URL42/epaper-cam/(commit log)

2026-08-15 chore: initialise repository
    macOS metadata and Arduino "Export compiled binary" output.
2026-08-15 docs: add hardware reference and build kickoff
    CLAUDE.md is the authoritative hardware reference: bill of materials, the
    Driver Board vs Breakout Board naming trap, pin map, Arduino IDE settings,
    image pipeline constraints and known risks. Items needing bench confirmation
    are marked VERIFY.
    kickoff-prompt.md defines the eight-phase build order, one flashable phase
    at a time.
2026-08-15 feat(phase1): add panel bring-up sketch
    Two full refreshes, nothing else. No camera, no button, no sleep.
    Test A draws asymmetric corner markers, a 1px border, vertical lines every
    100px and text, proving wiring, orientation and refresh timing.
    Test B pushes a raw 48,000-byte packed 1bpp buffer (left half 0xFF, right
    half 0x00) through drawBitmap to settle the bit-polarity VERIFY in the
    format the Phase 4 ditherer will emit.
    driver.h sets BOARD_SCREEN_COMBO 502 and USE_XIAO_EPAPER_DRIVER_BOARD,
    sourced from Seeed's 7.5" panel Arduino cookbook. This resolves the VERIFY
    in CLAUDE.md: the Driver Board wiki's USE_XIAO_EPAPER_BREAKOUT_BOARD is a
    copy-paste error from the Breakout Board page.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
    [driver.h]
2026-08-15 docs: fold Phase 1 bench results into hardware reference
    Both VERIFY markers resolved on hardware:
    - BOARD_SCREEN_COMBO 502 with USE_XIAO_EPAPER_DRIVER_BOARD is correct.
    begin() returns and update() completes, so BUSY is on D2 as documented.
    - Bit polarity is set-bit-equals-black. The ditherer emits 1 for black and
    passes TFT_BLACK as foreground. Seeed's "Reverse color" note describes
    their converter's output, not drawBitmap's input.
    New findings recorded:
    - Origin is top-left, no rotation needed. Test A placed its asymmetric
    markers as intended; Test B ruled out 180 degree rotation and horizontal
    mirroring.
    - Full refresh is 3433 ms, identical across runs. Replaces the ~5s esti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
2026-08-15 feat(phase2): add debounced shutter button with hold detect
    Serial only, panel untouched. Reports TAP (press and release under 1.5s)
    and HOLD (fired the instant 1.5s elapses while still held).
    Design notes:
    - Polling rather than an ISR. A human-pressed button does not justify
    IRAM_ATTR and volatile state, and Phase 7's EXT0 wake is a separate
    hardware mechanism that this does not foreclose.
    - HOLD fires at the threshold, not on release, so Phase 7 can give feedback
    at the moment the mode changes. The hold_reported flag suppresses the tap
    that would otherwise follow on release, so one press yields one event.
    - 25ms debounce. Bench-validated over nine presses with zero double-fires;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
2026-08-15 feat(phase3): add camera bring-up with luma histogram
    Init OV2640 at SVGA grayscale, discard three warmup frames for AGC to
    settle, capture one frame, report format/dimensions/length and a 16-bucket
    luma histogram. Panel untouched.
    Pin map copied verbatim from the ESP32 core's camera_pins.h under
    CAMERA_MODEL_XIAO_ESP32S3, rather than typed from memory. Inlined because
    that header sits in an examples folder outside the sketch include path.
    The verdict block prints last, after the histogram, so the result stays
    visible in a serial monitor scrolled to the bottom.
    Fields needed after capture are copied into locals before
    esp_camera_fb_return, since the driver may recycle the struct for the n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
2026-08-15 docs: record Phase 3 camera measurements
    - CONFIRMED: FRAMESIZE_SVGA with PIXFORMAT_GRAYSCALE returns exactly
    800x600 at 480,000 bytes, one byte per pixel. No JPEG decode step needed.
    - One frame buffer costs 481,376 bytes of PSRAM including driver overhead,
    leaving 7,904,720 free. Roughly 16 frames of headroom, so Phase 6's
    burst-and-pick-sharpest is not memory constrained.
2026-08-15 feat(phase4): add Floyd-Steinberg ditherer with native test harness
    Pure C11, no Arduino headers, no allocation, no I/O. Serpentine scan to
    avoid the diagonal worm texture a plain raster scan produces. Caller owns
    every buffer, so the function cannot fail and has nothing to free.
    800x600 8-bit luma in, packed 1bpp 800x480 out with the 120-row centre crop.
    MSB-first, 1 = black, matching the convention confirmed on the panel in
    Phase 1. Dithers only the 480 kept rows rather than cropping afterwards.
    Error accumulates in int32_t and is clamped to 0..255 before thresholding.
    Accumulating in uint8_t is the usual way this algorithm goes wrong: 255 + 3
    wraps to 2 and a white pixel turns black, wh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
    [dither.c, dither.h]
2026-08-15 feat(tools): add focus assist and scaler A/B bench tools
    Diagnostics for the image-quality investigation. Neither is a build phase.
    FocusAssist prints variance-of-Laplacian over the centre 400x300 several
    times a second, so a fixed-focus lens can be set by watching a number peak
    instead of eyeballing 3.7s panel refreshes. This found the actual problem:
    the lens was badly out of focus, and the score swung 40x across the barrel's
    travel. Peak on a text target is ~824 with +/-0.7% repeatability.
    The peak reading decays rather than latching, since a plain running maximum
    becomes useless the moment you overshoot. Accumulators are int64_t because
    120,000 squared Laplacian values overflow 32 bits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
2026-08-15 feat(tools): add frame dump and host receiver
    Sends one raw 800x600 grayscale frame over serial so tone mapping can be
    developed against real photographs on the Mac rather than guessed at through
    reflash-shoot-squint cycles on the bench.
    Raw bytes rather than base64: this is native USB CDC, where the nominal baud
    is ignored and throughput is USB-limited, so 480KB moves in about half a
    second. Measured 858-877 KB/s.
    recv_frame.py triggers the capture itself, so there is no button timing to
    coordinate, and writes PGM — viewable directly and trivial for the C harness
    to load. It clears DTR/RTS before opening because pyserial's defaults reset
    the S3's USB-Serial/JTAG, and it names the Serial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
    [recv_frame.py]
2026-08-15 feat: add tone mapping ahead of the dither
    A 1-bit panel renders midtones as 50% dot patterns, so a tonally ordinary
    photograph becomes grey mush no matter how sharp it is. tone.c pushes tones
    apart before quantisation.
    Global maths collapses into a 256-entry LUT, so the per-pixel device cost is
    one array lookup rather than two pow() calls. The S-curve is
    x^a/(x^a+(1-x)^a) rather than the usual scale-around-midpoint, because it
    cannot clip: it fixes 0, 0.5 and 1 for every a and only steepens the middle.
    TONE_DEFAULTS was settled empirically with tune against all three reference
    frames. The result was counter-intuitive: contrast 1.5-2.0 crushed the
    backlit portrait to a silhouette, and what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
    [tone.c, tone.h]
2026-08-15 feat(phase5): first working camera, with tone mapping
    Button, capture, tone, dither, blit. Everything the previous phases proved,
    wired together.
    - Shutter fires on the debounced press edge rather than release. Phase 2
    reported on release so it could distinguish a hold; with hold detection out
    of scope here, waiting would add the length of the press to shutter lag.
    - The frame is validated before dither_fs sees it. That function indexes
    480,000 bytes with no bounds checks by design, so the trust has to be
    earned somewhere, and this is where.
    - The frame buffer is returned before the 3.4s panel refresh, not after.
    Holding the driver's only buffer across it would stall the next capt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
    [dither.c, dither.h, driver.h, tone.c, tone.h]
2026-08-15 chore: keep photographs out of the repository
    The reference captures in frames/ are of a real home and a real face. They
    are only needed locally, for tuning the tone curve with dither/tune, so they
    stay on disk and out of git.
    Also drops the earlier !frames/*.pgm exception and removes the commit that
    added them, rather than only ignoring them going forward. An ignore rule does
    nothing about blobs already in history; they would have been published on the
    first push. Safe to rewrite here because this repo has never had a remote.
2026-08-15 feat: add 4-level greyscale dithering
    dither_fs_gray4 keeps the serpentine Floyd-Steinberg structure and changes
    only the quantiser and the output packing: nearest of four evenly spaced
    levels, emitted as 4bpp with two pixels per byte and the high nibble holding
    the even-x pixel. That is precisely the layout initGrayMode(GRAY_LEVEL4)
    gives its sprite, so callers can dither straight into it via getPointer().
    Four levels is not a marginal change. At two levels every pixel is wrong by
    up to 127 and the error has to be spread over a wide neighbourhood, and that
    spreading is what the eye reads as stipple. At four the worst case is ~42,
    diffusion stays local, and the texture largely disappears.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
    [dither.c, dither.h]
2026-08-15 feat: turn sharpening off by default
    At 1-bit the unsharp mask was the main thing making edges read and 0.9 was
    worth its cost. At 4-level grey it turned out to be invisible: a side-by-side
    of 0.9 and 0.0 on the panel was indistinguishable, while still costing 863ms
    of the 894ms tone stage. The levels now do the work the mask used to.
    Measured on device by toggling live: tone 894ms at sharp 0.9, 30ms at 0.0.
    The blur's vertical pass strides 800 bytes per read through PSRAM, which is
    why it dominated. Turning it off deletes the need for the sliding-window
    rewrite that was queued to fix it.
    The unsharp code stays in tone.c. It is tested, cleanly gated behind
    sharp_amt > 0, and costs nothing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
    [tone.h]
2026-08-15 feat(tools): add greyscale test, image test, and test chart
    Three bench tools from the greyscale investigation.
    GrayTest times a 1-bit refresh against a 4-level one and draws bands to
    confirm the levels are genuinely distinct. It is how we learned greyscale
    costs only 1.48x mono rather than the 5-10x that would have killed it.
    ImageTest pushes a pre-processed image straight into the panel from flash,
    with no camera in the loop. This separated two questions that had been
    tangled together for hours — "how good can this panel look" from "how good
    can this camera get" — and answered the first decisively: a good source
    renders with legible body text and smooth walls. Everything remaining is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
2026-08-15 feat(phase5): 4-level greyscale output and live tone tuning
    initGrayMode(GRAY_LEVEL4) at boot, dither_fs_gray4 writing straight into the
    sprite via getPointer(), and epaper.update(). The 48KB 1-bit buffer is gone
    rather than grown to 192KB, and free PSRAM went up 833KB as a result. The
    fillScreen before each blit is gone too: every pixel is written now, so there
    is nothing of the previous photo left to clear.
    Measured on device: capture 0 | tone 30 | dither 135 | paint 5074 | total
    5239 ms. Greyscale costs 1.6s a shot over 1-bit and is worth it without
    argument.
    Serial keys retune tone live — s/S sharpen, g/G gamma, c/C contrast, r/R
    radius, 0 sharpening off, x shoot, ? show values. Tone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
2026-08-15 docs: correct the greyscale premise and record datasheet figures
    The reference claimed the panel was 1-bit only and that dithering was the
    only way to render tone. Both were wrong, and it is the most expensive error
    in this document so far — it framed the entire image pipeline around a
    constraint that did not exist. Corrected in place, with the correction marked
    so the mistake stays visible.
    Recorded from the T075A04 datasheet: UC8179 controller, 124 DPI, white L*=63
    and black L*=32 for a contrast ratio near 4.5:1, ghosting dE <= 2, 100 mAs
    per update, 11 mA update current, 7 uA panel sleep. Those numbers also settle
    a Phase 7 question early: at 0.028 mAh a refresh, a 1000mAh cell covers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
2026-08-16 fix: dither against measured grey levels, not assumed ones
    dither_fs_gray4 assumed the four levels rendered at 0/85/170/255. Measured
    with PaperCam_GrayCalib they are nearer 0/60/138/255 — the waveform spaces
    them evenly in perceived lightness, which is not even in luminance.
    This was not cosmetic. Error diffusion subtracts the value it believes it
    wrote and passes the remainder on, so believing 85 while the panel shows 60
    injected 25 of unaccounted error per pixel. It accumulated as a systematic
    darkening over three quarters of every image, and no tone curve could undo it
    because the tone curve runs first. It explains why on-panel results always
    came out heavier than the previews promise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
    [dither.c, dither.h]
2026-08-16 feat(tools): add grey level calibration sketch
    Measures the two middle grey levels by comparison rather than instrumentation.
    Each solid level sits beside eight black/white Bayer patches at known white
    fractions; the one it disappears into gives that level's true reflectance as a
    fraction between the panel's black and white.
    Ordered Bayer rather than random, because a uniform texture is far easier to
    compare against a solid patch than noise is. Labels sit below the patches, not
    inside them, since text within a patch would change the average being read.
    [driver.h]
2026-08-16 feat: neutral gamma now that the level table is correct
    Gamma drops from 1.35 to 1.00. The lift was tuned while the ditherer still
    assumed 0/85/170/255, so it had been quietly compensating for a darkening the
    ditherer was causing and did not know about. Correcting the level table turned
    that compensation into double-counting and shots came out washed.
    Two errors had been cancelling. Fixing one exposed the other, and with an
    accurate level table the pipeline wants to be tonally neutral.
    Phase 5 also gains runtime sensor controls ([/] sharpness, ;/' denoise,
    -/= exposure bias) and a capability probe, each reporting the driver's return
    code so an unsupported control says so instead of silentl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
    [tone.h]
2026-08-16 feat(phase6): burst capture, sharpness rejection, frame averaging
    Capture six frames, score each by variance of the Laplacian, discard the ones
    that moved, average the rest. Targets NOISE rather than blur, which departs
    from the original plan of "keep the sharpest frame" — that plan is right when
    the enemy is camera shake, but by this point focus was fixed, greyscale was
    working and the levels calibrated, and the visible defect left was sensor
    grain. Averaging cuts random noise by sqrt(N); six frames is about 2.4x.
    Two bugs found on the first run, both visible in the score log:
    - The first frame of every burst is the driver's pre-buffered one, captured
    before the shutter under differen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
    [PaperCam_Phase6.ino, dither.c, dither.h, driver.h, tone.c, tone.h]
2026-08-16 docs: correct the sensor to OV3660 and record the frame latency trap
    The board has an OV3660 (PID 0x3660), not an OV2640. Newer Sense batches ship
    the 3MP part and neither the listing nor the wiki mentions it. This document
    asserted OV2640 for six phases and the error shaped real conclusions: the
    softness in our photos was written off as a hardware ceiling precisely because
    the OV2640 driver implements almost no processing controls. The OV3660 driver
    implements all of them, and sharpness and denoise both visibly help.
    It also invalidates the Phase 5 scaler test. That concluded UXGA plus software
    downsampling was 10% worse than SVGA-native, reasoning from a 1600x1200 native
    array. The OV3660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
2026-08-16 refactor: restructure into PaperCam plus bench tools, add self-timer
    Two changes that should have been separate commits; they were staged together
    by accident and are recorded honestly here rather than left mismatched.
    RESTRUCTURE
    The phased bring-up folders had served their purpose and were mostly
    duplication. Layout is now:
    PaperCam/ the camera (was PaperCam_Phase6)
    bench/ FocusAssist, GrayCalib, GrayTest, ImageTest, FrameDump
    dither/ modules, native harness, tone playground
    tools/ recv_frame.py, make_testchart.py
    Retired: Phase1, Phase2, Phase3, Phase5, ScalerTest.
    Phase 5 was genuinely redundant — PaperCam with the burst set to 1 frame is
    Phase 5, same pipe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
2026-08-16 docs: add README
    Written for someone arriving with the same hardware, rather than as a summary
    of the project. Leads with the two findings that cost the most time and are
    hardest to search for: the Driver Board wiki's copy-paste error, which
    compiles to an empty program and uploads silently, and that this panel does
    4-level greyscale despite being sold and specified as black-and-white.
    Also records the grey levels being unevenly spaced, since anyone implementing
    error diffusion against this panel will hit the same systematic tonal shift,
    and the USB CDC trap where a successful upload is not evidence that Serial
    works.
    Status section is honest about what is unfinished and what remains unexp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
2026-08-16 feat: move shutter to D5, add tap versus hold
    The switch is wired, so the shutter leaves GPIO0 for its intended home. GPIO0
    served during bring-up but could never be final: the ROM re-samples strapping
    pins coming out of deep sleep, so a wake triggered by holding it low would
    enter download mode rather than take a photo. GPIO6 is RTC-capable and carries
    no strapping role.
    Tap takes a photo, hold is reserved for uploading and currently only
    acknowledges with three LED flashes. The trigger moves from press edge to
    release, which would normally cost responsiveness — but the self-timer already
    imposes three seconds before capture, so the 1.5s spent deciding tap-or-hold
    is invisible. Hold fire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
2026-08-16 feat: encode each photo to JPEG and save it to flash
    fmt2jpg on the averaged frame, written to /last.jpg on the SPIFFS partition
    the 8M-with-spiffs scheme already provides. One file, overwritten each shot.
    Flash rather than PSRAM because it has to survive deep sleep — a photo you
    cannot upload after the device naps is not much of an archive. Confirmed on
    the bench: 37,536 bytes, still present after a reboot.
    Encoded after the panel refresh, deliberately. The photo is already on the
    panel by then, so the encode and flash write cost the viewer nothing and only
    affect how soon the next shot can start.
    Encoded from the cropped, tone-mapped frame, so the JPEG matches the panel's
    framing minu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
    [PaperCam.ino]
2026-08-16 feat: upload the last photo over WiFi on a button hold
    Hold the shutter and the camera joins WiFi, POSTs /last.jpg, and turns the
    radio off again. Confirmed end to end: 45,059 bytes, HTTP 200 in 493ms, and
    the receiver decoded it as a valid 800x480 greyscale JPEG.
    WiFi stays off until asked. That is the whole design — idle WiFi is what
    drains a battery, whereas connect-send-disconnect costs roughly 0.15 mAh, some
    five times a panel refresh but still ~5,000 uploads from a 1000mAh cell.
    Measured connect time is 1.6-2.3s, faster on repeats as the ESP32 caches the
    AP's channel.
    Because uploading is a deliberate gesture rather than automatic, there is no
    retry queue, no backoff and no silent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
2026-08-16 feat: deep sleep after five idle minutes, wake on the shutter
    Sleeps on an idle timeout, wakes via EXT0 when the shutter pulls D5 low.
    Confirmed on the bench: sleeps, the serial port disappears, a press brings it
    back reporting "woke: shutter pressed", and LittleFS still holds the JPEG.
    Waking does not take a photo. One press wakes, the next shoots. Wake-and-shoot
    would save a press, but there are two gestures on this button now and a wake
    that always fires the shutter would make hold-to-upload unreachable from
    sleep.
    Nothing in the sleep or wake path touches the panel. Drawing into the sprite
    is free; pushing it would blank the photograph the device is sleeping to
    preserve, which is the w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
2026-08-16 fix: keep the photo on the panel when waking from sleep
    Waking showed the welcome screen instead of the last photograph, which defeats
    the point of an e-paper frame that holds its image with no power.
    The sleep path never touched the panel, which is what I checked and why I
    missed this. Waking is not a resume — it is a full boot through setup() — and
    setup() ended with an unconditional show_message, so every wake repainted.
    "The sleep path is clean" was true and irrelevant.
    The welcome screen is now cold-boot only, keyed off
    esp_sleep_get_wakeup_cause(). Error screens still paint on any boot: a
    hardware failure is worth losing the picture over, since otherwise you stare
    at an old photo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
    [PaperCam.ino]
2026-08-16 docs: bring the README up to date with Phase 7
    It was written before the button, JPEG storage, WiFi upload and deep sleep
    existed, and still claimed sleep was unfinished.
    Adds the tap/hold model, the save-and-upload path, the three new serial keys,
    and an Uploading section covering the secrets.h pattern and why the Google
    Drive credential belongs in n8n rather than on a microcontroller.
    The Status section is rewritten around what is actually left: an enclosure and
    battery operation. It also records the finding that makes battery life
    uncertain — PWDN_GPIO_NUM is -1 on this hardware, so the camera's power-down
    pin is not wired to the ESP32 and software cannot cut its power, which leaves
    i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
2026-08-16 feat: add sensor flip controls, defaulting to no flip
    vflip and hmirror exposed as v and h, reported at boot with their return codes.
    Both default OFF, which is correct for the intended mounting — camera above
    the panel, landscape. Earlier photos looked inverted only because the board
    was being held loose at the bench, and defaulting them on would have rotated
    a correct image by 180 degrees.
    Kept as knobs because the enclosure decides this. Both on is a rotation;
    either alone is a mirror, which is worse than upside down since text becomes
    unreadable rather than merely wrong way up. The OV3660's DSP applies them
    during readout, so they cost no buffer and no cycles.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
    [PaperCam.ino]
2026-08-16 feat(case): parametric OpenSCAD enclosure, first draft
    Standalone printed case rather than a bezel for a bought frame: battery
    inside, button on the top edge, camera above the panel looking forward.
    175.8 x 147.2 x 25.4mm, fits the A1 bed flat. The depth is almost entirely the
    19mm board stack — bezel 2.5 + panel 1.1 + board 19 + wall 2.4 — so soldering
    the XIAO down instead of socketing it is the only meaningful way to make this
    thinner.
    Everything is a named variable, because several of the inputs are uncertain
    and a wrong one should be a one-line fix:
    - Panel outline and active area come from the T075A04 datasheet.
    - Battery 10x34x50 from the LP103450 part number.
    - Driver board 41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
    [papercam.scad]
2026-09-05 feat(case): reverse the shell, mount everything to the front
    Reworked to the requested layout.
    Walls now belong to the FRONT, which becomes the deep part carrying the
    bezel, the panel, the board, the battery and the camera. The back is a flat
    cover held on by M2 screws into heat-set inserts — 3.2mm bores in the bosses,
    2.4mm clearance and a countersink in the cover.
    The panel gets a rebate on the inside of the front face, glass outline and
    1.1mm deep, sitting around the smaller active-area window, so the glass seats
    flush behind the bezel and the border and FPC tail stay hidden.
    Board and battery both mount vertically, since the camera has to reach the top.
    Battery pocket sits to the le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
    [papercam.scad]
2026-09-05 fix: never repaint the panel when a photo already exists
    Powering the board off and on wiped the picture and drew the welcome screen.
    The previous fix keyed the welcome screen on from_sleep, which only covered
    waking. A cold boot still repainted — and a cold boot is exactly what happens
    every time the battery is disconnected and reconnected, which for a
    battery-powered frame is the common case rather than the rare one.
    Now keyed on whether /last.jpg exists. If a photo has ever been taken the
    panel is assumed to be showing it and is left alone, however we booted. The
    welcome screen appears only on a genuinely fresh device.
    Error screens still paint on any boot: a hardware failure is wort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
    [PaperCam.ino]
2026-09-05 refactor(case): strip it back to a shell, a cover, and foam tape
    Board posts, battery pocket and camera retainer are gone. Printed mounts earn
    their keep in production; for one unit each is another measurement that can be
    wrong, and every wrong one costs a three-hour print. Everything inside is now
    held with foam tape and Velcro.
    The important consequence is an inversion: the camera aligns to the hole
    rather than the hole to the camera. Hold the module against the inside of the
    front face, centred in the bore, stick it down. That removes every hard
    constraint this design had been fighting — the ribbon length, where the camera
    sits on the board, whether the board lives in the top band or b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
    [papercam.scad]
2026-09-05 fix(case): five bosses, and place the window from measured panel borders
    Two bench findings.
    A screw boss sat at top-centre, which is exactly where the camera is. Gone —
    five screws now, three along the bottom and one at each top corner. The top
    edge keeps its corners and leaves the camera alone.
    More importantly, the panel's active area is NOT centred in the glass. The
    datasheet gives the outline as 111.2 and the active area as 97.92 but never
    says how the 13.28mm of border divides. Measured: 3mm on the plain long edge
    and 10.28mm on the FPC edge, which sums to 13.28 almost exactly. Assuming it
    centred put the window 3.64mm too high — visible, and the sort of error a
    first print exist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
    [papercam.scad]
2026-09-05 fix(case): give the panel an actual ledge to sit on
    The rebate was doing nothing. The main cavity is inset by `wall` (2.4mm) while
    the panel sits 2.8mm in, so the cavity was already larger than the glass in
    every direction and a pocket cut to panel size removed material that had
    already been removed. There was no step to see because there was no step.
    The cavity behind the panel now steps in by 3.5mm — matching the panel's own
    side border, so the shelf sits entirely under the glass margin and never
    intrudes on the active area. The panel drops into a pocket the depth of the
    rebate and lands on a real ledge, with room behind for tape.
    Two openings had to follow: the button hole and the USB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
    [papercam.scad]
2026-09-05 fix(case): overlap the panel pocket so the window stops looking blocked
    The pocket's back face sat at z=4.4 and the deep cavity's front face began at
    z=4.4 — exactly coincident. Two subtracted volumes sharing a coplanar surface
    make OpenCSG render a ghost membrane, which showed up as something apparently
    covering the screen opening.
    The pocket now overlaps the cavity by 0.1mm. The camera well already did this;
    the pocket did not, which is why one looked right and the other did not.
    Worth remembering for anything added later: always overlap subtracted solids
    rather than butting them exactly.
    [papercam.scad]
2026-09-05 feat(case): shift the camera 20mm toward the button
    The panel's FPC leaves the middle of the top edge and has to fold back into
    the case, so the centre of the top band belongs to the ribbon rather than the
    lens. The camera moves from x=87.9 to x=107.9.
    Clearances checked: 45.9mm to the button, 50.2mm from the camera well to the
    top-right boss, and the well now starts 9mm right of the centreline, leaving
    the middle of the top band free for the ribbon.
    Exposed as cam_offset_x so it can be nudged once the ribbon is actually folded
    in place.
    [papercam.scad]
2026-09-05 feat(case): another 10mm of camera offset
    cam_offset_x 20 -> 30, putting the lens at x=117.9. Clear space right of the
    centreline before the camera well starts goes from 9mm to 19mm, which is where
    the panel's ribbon needs to fold.
    Still 35.9mm clear of the button and 40.2mm from the well to the top-right
    boss, so nothing is crowded.
    [papercam.scad]
2026-09-06 fix(case): loosen the panel fit, recentre the camera in its band
    Three bench notes.
    The glass was a fight to seat. panel_clear is now its own parameter at 1.5mm a
    side rather than sharing the general 0.4mm, so it drops in and is still hidden
    behind a 3.5mm bezel overlap. The shell grows 2.2mm, which costs nothing.
    The camera is centred horizontally again — the board will sit behind the glass
    with the lens folded forward beside the ribbon, rather than being shoved
    sideways to clear it.
    Vertically it is now centred between the top of the panel pocket and the inner
    face of the top wall, which is not the same as half the nominal bezel. The old
    figure put the 22mm well's top edge 0.05mm PAST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
    [papercam.scad]
2026-09-06 feat(case): keyhole hangers on the back cover
    Two keyholes near the top of the back plate, 100mm apart, so the frame hangs
    on a pair of wall screws.
    Two rather than one because a 178mm frame on a single hook pivots — and fixing
    the orientation means it cannot be hung with the camera at the bottom, which
    was the point of asking.
    The slot rises ABOVE the round hole, which is the direction that actually
    works: the frame drops under gravity, so the screw travels UP relative to the
    plate and is captured by the narrow section with its head trapped behind. Slot
    below the hole would let it lift straight off.
    Each keyhole gets a 2.5mm pad on the inside face, spanning the slot as well as
    the roun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
    [papercam.scad]
2026-09-07 fix(case): 2.5mm clearance along the panel's length, ledge preserved
    The glass almost slid in. Clearance is now per axis, since only the long
    dimension was tight: 2.5mm a side along the 170.2mm length, 1.5mm on the
    height. Both stay hidden behind the 3.5mm bezel overlap.
    The cavity is now inset from the PANEL edge rather than the outer edge. Tied
    to the outer edge, every extra millimetre of clearance ate a millimetre of the
    shelf the glass rests on — this change would have taken the ledge from 2.0mm
    down to 1.0mm. It now stays a full 3.5mm however the clearances are set, which
    is the number that should be constant.
    The USB slot follows: it runs from the cavity edge outward instead of a f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
    [papercam.scad]
2026-09-07 feat(case): flexible fingers instead of a bottom ledge, so the panel goes in
    The panel could not be fitted at all, and the ledge was the reason. With 3.5mm
    of shelf each side the gap between ledges is 163.2mm; the panel is 170.2mm. It
    cannot pass through from the back however much clearance the pocket is given,
    because the pocket was never what stopped it. The support feature was trapping
    the thing it supported.
    The bottom edge now has no ledge. Three ramped cantilever fingers stand in its
    place: push the glass in from behind, the fingers deflect back, it seats
    against the bezel, they spring over its rear face and retain it. Top and both
    sides keep their solid ledge, so three edges still su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
    [papercam.scad]
2026-09-07 feat(case): drop the side ledges so the panel lays straight in
    The entry opening grows exactly 7.75mm, from 163.2 to 170.95, for a 170.2mm
    panel. It now drops in flat from the back with 0.375mm either side.
    Trying to slide the glass in edgewise was solving the wrong problem. The
    pocket is 1.9mm deep and the panel is 170mm of rigid glass — there is no angle
    at which it goes through a 163.2mm gap, and no amount of lead-in makes one.
    The fix is to stop obstructing it.
    The ledge was there to support the glass, but it was never doing that job
    alone: the bezel lip holds it forward, the fingers along the bottom edge hold
    it back, and tape does the rest. None of those are in the way during assem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
    [papercam.scad]
2026-09-07 feat(case): counterbore the button wall from 5.9mm to 2.9mm
    The top wall is not `wall` thick where the button goes. It is wall +
    panel_ledge = 5.9mm, because the 3.5mm shelf that used to run round the panel
    is still present along the top edge — the side ledges went away, that one did
    not. A panel-mount switch has a short thread and cannot reach through it.
    A 14mm counterbore from the inside leaves 2.9mm of material outside, 51%
    thinner, with room for the nut and a socket to tighten it. It clears the
    top-right screw boss by 8.3mm.
    [papercam.scad]
2026-09-07 feat(case): board channel around the camera
    Two ribs hanging off the inside of the top wall, forming a 26mm slot the board
    drops into — 25.4mm board plus slip, so it guides rather than grips. Runs 25mm
    down from the top wall and 15mm back from the panel plane.
    Taping to a board's edges is far easier than reaching into a box to stick its
    face to something, and the channel locates the camera over the lens hole
    without needing to know where the mounting holes are. The tape still does the
    holding; these just stop it wandering.
    The 16mm camera well sits inside the channel, and it clears the nearest screw
    boss by 68mm. It runs 2.9mm past the panel's top edge, so the board's lower
    part sits beh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
    [papercam.scad]
2026-09-07 feat(case): ribs to full depth, with gussets bracing them sideways
    cam_wall_h 15 -> 20, taking the ribs from z=4.4 to z=24.4, which is 0.2mm off
    the back cover. Not the 22 asked for: the ribs stand on the shelf at z=4.4 and
    the interior ends at 24.6, so 20.2mm is all there is and 22 would poke through
    the cover. It reaches the board regardless — with the camera against the front
    face the board's back sits near z=21.5.
    Each rib gets two triangular gussets, 6mm base by 11mm tall, on its OUTER face
    so nothing intrudes into the board slot. They brace sideways, which is the
    direction a 2mm x 20mm rib actually fails in — along its length it was already
    stiff. Both sit inside the top band, sin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
    [papercam.scad]
2026-09-07 fix(case): ribs stop at the pocket edge so the panel can still go in
    At 25mm the ribs hung 2.9mm past the top of the panel pocket — directly into
    the path the glass travels on its way in. It would have jammed on assembly,
    after we had just spent several rounds clearing that path.
    cam_wall_len is now derived rather than chosen: inner_top_y - pocket_top_y,
    which is 22.1mm. The ribs fill the top band exactly and stop dead at the
    pocket, so the number cannot drift back into the panel's way when something
    else moves.
    Both gussets already sat well clear at y=140.8 and y=129.8.
    [papercam.scad]
2026-09-07 refactor(case): remove the USB opening
    With the board in the top band and its camera pressed against the front face,
    the USB-C port ends up somewhere no cable can reach — there is no straight line
    from any exterior face to the connector. A slot in the side wall would have
    opened onto plastic.
    Charging now means five screws and lifting the board out. That is acceptable
    against a 2000mAh cell and weeks between charges, and it is recorded in the
    source so the reasoning is not lost. If it becomes tiresome the fix is a short
    USB-C pigtail glued into the bottom wall, or charging through the driver
    board's BAT connector.
    [papercam.scad]
2026-11-01 fix: keep the chosen sensor settings, sleep the panel at boot
    The capability probe in setup() called each sensor setter with 0 after
    the bench-chosen sharpness 3 / denoise 5 had been applied, and the
    first-shot report did it again. Every boot, including every wake from
    deep sleep, ran the camera at 0/0. Probe first, then apply; the shot-1
    report now re-applies the current values instead of writing 0.
    EPaper::begin() leaves the UC8179 powered on while the library's flag
    claims it is asleep, so nothing slept it on the photo-exists path and
    it stayed powered through idle and ESP32 deep sleep. wake() + sleep()
    right after initGrayMode re-inits it without a refresh and powers it
    down.
    Also turn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
2026-11-01 feat(case): lens-datum board pins, USB-C slot, test coupon
    Locate the board from the lens instead of by hand. Two pins on the back
    cover go through the driver board's middle holes and press it forward.
    They are placed from the lens hole, which serves as the datum.
    - Widen the lens hole to 7mm (+-1.9mm slop) and move its countersink to
    the front face.
    - Cut a USB-C slot through the top wall, sized for the plug's moulding.
    - Move the cover's screw countersinks to the outside face.
    - Shorten the panel hooks and make them rigid.
    - Add coupon_shell / coupon_back: a quick test pair cut from the real
    parts, for checking pin, lens and USB-C fit.
    The lens-to-board numbers are fit-checked by the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
2026-11-07 feat: shutter edge log, LED busy rule, drop presses made while busy
    The button was missing presses, and the serial log could not tell why:
    the debouncer reports only what it accepts.
    - Edge log: a CHANGE interrupt on D5 timestamps every raw edge into a
    64-entry ring. loop() prints the edges, and presses made while busy are
    tagged. This separates three causes: the pin never moved (wiring),
    chatter or presses too short to count (bad contact), and presses made
    while busy. It is on by default; 'd' toggles it.
    - LED rule: lit, solid or blinking, means busy and the shutter is
    ignored; dark means listening. The LED is now solid through boot,
    starting before the 2s serial wait, and soli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
